ChrisAlonzo7/EC464SARTopo/Android Flutter App/assets/Background.PNG

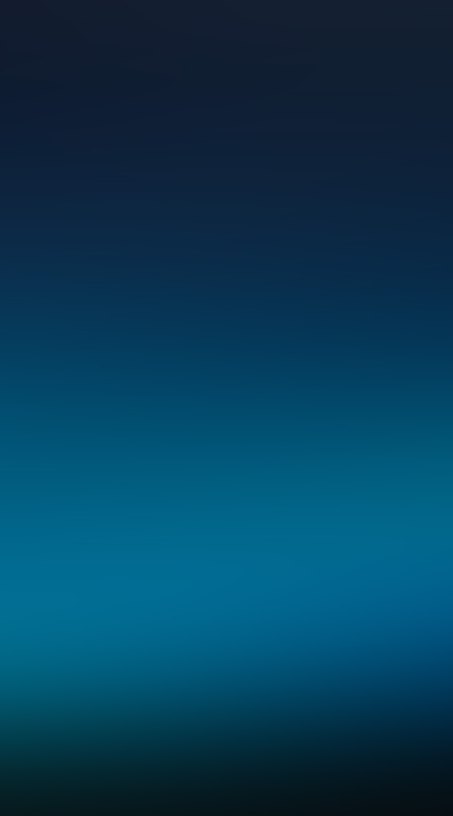
Android Flutter App/assets/Background.PNG
