ChrisAlonzo7/EC464SARTopo/Android Flutter App/assets/SRBI.PNG

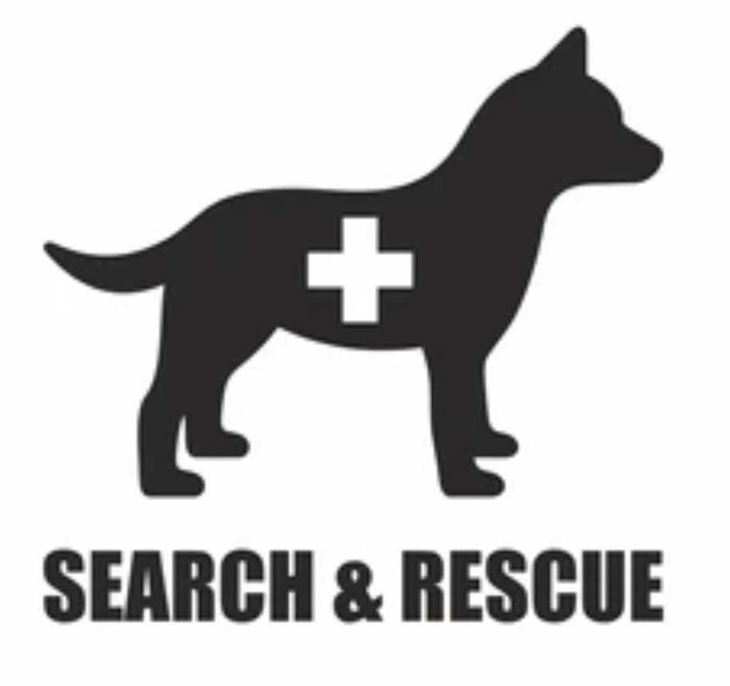
Android Flutter App/assets/SRBI.PNG
