ChrisAlonzo7/EC464SARTopo/(commit log)

2023-02-25 Accelerometer Starting Code
2023-02-27 Updated to print location every 2 seconds
2023-02-27 Track Multiple Devices
    This enables us to track multiple devices at once and see it on a saved SARTopo map
2023-03-02 LED Turning Red
2023-03-29 finished accelerometer code
2023-03-29 reuploading LED Code
2023-04-27 Update README_HARDWARE.md
    adding circuit diagram
